lo1ol/DarkroomTimer/DarkroomTimer/src/SettingsSetter.cpp

#include "SettingsSetter.h"

#include "Hardware.h"
#include "Utils.h"

SettingsSetter::SettingsSetter() : m_lagTime(gSettings.lagTime) {
    repaint();
}

SettingsSetter::~SettingsSetter() {
    gBeeper.stop();
    gSettings.lagTime = m_lagTime;
    gSettings.updateEEPROM();
}

void SettingsSetter::processSetLagTime() {
    gSettings.lagTime = 0_s;
    if (gEncoder.getTime(m_lagTime, true)) {
        if (m_lagTime > kMaxLagTime)
            m_lagTime = kMaxLagTime;
        repaint();
    }

    m_timer.tick();
    if (m_timer.state() != Timer::STOPPED || m_timer.justFinished()) {
        repaint();
        return;
    }

    if (gStartBtn.click())
        m_timer.start(m_lagTime);
}

void SettingsSetter::processSetBeepVolume() const {
    if (!gEncoder.getInt(gSettings.beepVolume, kMinBeepVolume, kMaxBeepVolume))
        return;

    gBeeper.start();
    repaint();
}

void SettingsSetter::processSetAutoFinishView() const {
    if (gEncoder.getInt(gSettings.autoFinishViewMinutes, 0, kMaxAutoFinishViewMinutes))
        repaint();
}

void SettingsSetter::processSetBacklight() const {
    if (!gEncoder.getInt(gSettings.backlight, kMinBacklight, kMaxBacklight))
        return;
    setDisplayBacklight(gSettings.backlight);
    repaint();
}

void SettingsSetter::processStartWith() const {
    uint8_t choice = static_cast<uint8_t>(gSettings.startWith);
    if (!gEncoder.getInt(choice, 0, static_cast<uint8_t>(StartWith::last_) - 1))
        return;

    gSettings.startWith = static_cast<StartWith>(choice);
    repaint();
}

void SettingsSetter::processSetMelody() const {
    uint8_t choice = gSettings.melody;

    if (!gEncoder.getInt(choice, 0, Melody::last_ - 1))
        return;

    gSettings.melody = static_cast<Melody::Name>(choice);
    gBeeper.setMelody(gSettings.melody);
    gBeeper.alarm();
    repaint();
}

void SettingsSetter::processIdleTime() const {
    if (!gEncoder.getInt(gSettings.idleAfterMinutes, 0, kMaxIdleAfterMinutes))
        return;

    repaint();
}

void SettingsSetter::processIdleAnimation() {
    if (m_playingIdleAnim) {
        if (!gIdleShower.tick())
            return;

        gIdleShower.stopAnim();
        m_playingIdleAnim = false;
        gDisplay.setupCharset(Charset::Main);
        repaint();
    }

    if (gStartBtn.click()) {
        gIdleShower.startAnim(gSettings.idleAnimation);
        m_playingIdleAnim = true;
    }

    uint8_t choice = gSettings.idleAnimation;
    if (!gEncoder.getInt(choice, 0, DisplayAnimation::last_ - 1))
        return;

    gSettings.idleAnimation = static_cast<DisplayAnimation::Id>(choice);
    repaint();
}

void SettingsSetter::process() {
    if (couldBeClosed()) {
        int8_t shift = 0;
        if (gModeBtn.click())
            shift = 1;
        else if (gModeBtn.pressing()) {
            if ((shift = gEncoder.getDir()))
                gModeBtn.skipEvents();
        }

        if (shift) {
            gEncoder.clear();
            m_step = ADD_TO_ENUM(Step, m_step, shift);

            repaint();
            gBeeper.stop();
            gSettings.lagTime = m_lagTime;
            gSettings.updateEEPROM();
        }
    }

    switch (m_step) {
    case Step::setLagTime:
        processSetLagTime();
        break;
    case Step::setBacklight:
        processSetBacklight();
        break;
    case Step::setBeepVolume:
        processSetBeepVolume();
        break;
    case Step::setAutoFinishView:
        processSetAutoFinishView();
        break;
    case Step::setStartWith:
        processStartWith();
        break;
    case Step::setMelody:
        processSetMelody();
        break;
    case Step::setIdleTime:
        processIdleTime();
        break;
    case Step::setIdleAnimation:
        processIdleAnimation();
        break;
    case Step::checkVersion:
        break;
    case Step::last_:
        assert(false);
        break;
    }
}

void SettingsSetter::repaint() const {
    gDisplay.reset();

    gDisplay[0] << F(kWrenchSymTop " ");
    gDisplay[1] << F(kWrenchSymBottom " ");

    switch (m_step) {
    case Step::setLagTime:
        gDisplay[0] << F("Lag time");
        gDisplay[1] << ((m_timer.state() != Timer::STOPPED) ? Time::fromMillis(m_timer.left()) : m_lagTime);
        return;
    case Step::setBacklight:
        gDisplay[0] << F("Backlight");
        gDisplay[1] << gSettings.backlight;
        return;
    case Step::setBeepVolume:
        gDisplay[0] << F("Beep volume");
        gDisplay[1] << gSettings.beepVolume;
        return;
    case Step::setAutoFinishView:
        gDisplay[0] << F("Auto stop view");

        if (gSettings.autoFinishViewMinutes == 0)
            gDisplay[1] << F("No");
        else
            gDisplay[1] << gSettings.autoFinishViewMinutes << F(" minute")
                        << (gSettings.autoFinishViewMinutes == 1 ? "" : "s");
        return;
    case Step::setStartWith:
        gDisplay[0] << F("Start with");
        switch (gSettings.startWith) {
        case StartWith::Modes:
            gDisplay[1] << F("Modes");
            return;
        case StartWith::Settings:
            gDisplay[1] << F("Settings");
            return;
        case StartWith::last_:
            assert(false);
            return;
        }
        return;
    case Step::setMelody:
        gDisplay[0] << F("Notify melody");
        gDisplay[1] << Melody::getMelodyName(gSettings.melody);
        gDisplay[1] >> F(kBellSym);
        return;
    case Step::setIdleTime:
        gDisplay[0] << F("Idle time");
        if (gSettings.idleAfterMinutes == 0)
            gDisplay[1] << F("No");
        else
            gDisplay[1] << gSettings.idleAfterMinutes << F(" minute") << (gSettings.idleAfterMinutes == 1 ? "" : "s");
        return;
    case Step::setIdleAnimation:
        gDisplay[0] << F("Idle animation");
        gDisplay[1] << DisplayAnimation::getAnimationName(gSettings.idleAnimation);
        return;
    case Step::checkVersion:
        gDisplay[0] << F("Version");
        gDisplay[1] << F(TIMER_FIRMWARE_VERSION);
        return;
    case Step::last_:
        assert(false);
        return;
    }
}

bool SettingsSetter::couldBeClosed() const {
    return m_timer.state() == Timer::STOPPED && !m_playingIdleAnim;
}
