lo1ol/DarkroomTimer/DarkroomTimer/src/DisplayAnimation.h

#pragma once

#include <Arduino.h>
#include <stdint.h>

#if __has_include("new.h")
    #include <new.h>
#else
    #include <cstddef>
    #include <new>
#endif

struct ImgDesc {
    const uint8_t* img;
    uint8_t height;
    uint8_t width;
    uint8_t bytesInRow;
};

struct RenderedImgDesc {
    char row0Str[7];
    char row1Str[7];
    uint8_t customSymsCnt = 0;
    uint8_t customSyms[8][8];
};

class DisplayAnimation {
public:
    DisplayAnimation();

    // return time to next update
    virtual uint16_t tick() = 0;

    // random has to be first
    enum Id { random, dvd, dickKicker, sleepyTimer, spaceship, last_ };

    virtual ~DisplayAnimation() = default;

    // This class shouldn't be created in heap
    // Use placement new instead
    // It allows us to reduce firmware memory about 3%
    static void* operator new(size_t) = delete;
    static void* operator new(size_t size, void* location) { return ::operator new(size, location); }

    static void operator delete(void*) {}

    [[nodiscard]] static DisplayAnimation* createAnimation(Id);
    [[nodiscard]] static const __FlashStringHelper* getAnimationName(Id);

protected:
    static RenderedImgDesc renderImg(const ImgDesc& img, uint8_t xOffset, uint8_t yOffset);
    static void printRenderedImg(const RenderedImgDesc& desc, const int8_t col);
};

class BounceAnimation : public DisplayAnimation {
public:
    BounceAnimation(const ImgDesc* imgDesc, uint8_t xShift, uint8_t yShift);

    uint16_t tick() override;

private:
    int8_t m_xPos = 0;
    int8_t m_yPos = 0;

    int8_t m_xShift = 2;
    int8_t m_yShift = 1;
    const ImgDesc* m_imgDesc;
    const uint8_t kBaseXShift;
    const uint8_t kBaseYShift;
};

class DvdAnimation : public BounceAnimation {
public:
    DvdAnimation();
};

class RussianDickKicker : public DisplayAnimation {
public:
    uint16_t tick() override;

private:
    uint8_t m_currentFrame = 0;
    int8_t m_xPos = -4;
};

class SleepyTimer : public DisplayAnimation {
public:
    enum Phase : uint8_t { WakedUp, GoingToSleep, Sleep, WakingUp, last_ };

    uint16_t tick() override;

private:
    void setPhaseChars();
    void nextPhase();

    Phase m_phase = Phase::WakedUp;
    uint8_t m_inPhaseTime = 0;
};

class SpaceShip : public DisplayAnimation {
public:
    SpaceShip();

    uint16_t tick() override;

private:
    enum SpaceObject : uint8_t {
        Nothing,
        Star1,
        Star2,
        TwoStars,
        MiddleStar,
        BigStar,
        HugeStar,
        Planet,
        Galactic,
        Enemy,
        Satellite,
    };

    void shiftSpace();
    void shiftSpaceShip();
    char getSpaceObjectSym(SpaceObject);

    int8_t m_spaceshipYPos = 3;
    int8_t m_spaceShipDir = 0;

    uint16_t m_phase = 0;

    // each 4 bit of this object describes SpaceObject
    uint64_t m_r0spaceObjects;
    uint64_t m_r1spaceObjects;
    uint8_t m_lastBigObjectDistance = 0;
};
