lo1ol/DarkroomTimer/DarkroomTimer/src/Display.cpp

#include "Display.h"

#include "Lcd.h"

Display::Display(Lcd* lcd) : m_lcd(lcd) {
    int i = 0;
    for (auto& line : m_lines)
        line = DisplayLine(i++, m_lcd);
}

void Display::tick() {
    for (auto&& line : m_lines)
        line.tick();
}

void Display::reset() {
    for (auto&& line : m_lines)
        line.reset();
}

void Display::resetBlink(bool showBlinked) {
    for (auto&& line : m_lines)
        line.resetBlink(showBlinked);
}

void Display::setupCharset(Charset charset) {
#define ADD_CUSTOM_CHAR(symStr, symMatrix) m_lcd->addPROGMEMCustomChar(static_cast<uint8_t>(symStr[0]), symMatrix)
    switch (charset) {
    case Charset::Main:
        ADD_CUSTOM_CHAR(kWrenchSymTop, kWrenchSymTopMatrix);
        ADD_CUSTOM_CHAR(kWrenchSymBottom, kWrenchSymBottomMatrix);
        ADD_CUSTOM_CHAR(kSheetSym, kSheetSymMatrix);
        ADD_CUSTOM_CHAR(kPlaySym, kPlaySymMatrix);
        ADD_CUSTOM_CHAR(kPauseSym, kPauseSymMatrix);
        ADD_CUSTOM_CHAR(kBellSym, kBellSymMatrix);
        break;
    case Charset::ModePreview:
        ADD_CUSTOM_CHAR(kFolderBegin1Sym, kFolderBegin1SymMatrix);
        ADD_CUSTOM_CHAR(kFolderEnd1Sym, kFolderEnd1SymMatrix);
        ADD_CUSTOM_CHAR(kFolderBegin2Sym, kFolderBegin2SymMatrix);
        ADD_CUSTOM_CHAR(kFolderBegin3Sym, kFolderBegin3SymMatrix);
        ADD_CUSTOM_CHAR(kFolderEnd3Sym, kFolderEnd3SymMatrix);
        ADD_CUSTOM_CHAR(kFolderBegin4Sym, kFolderBegin4SymMatrix);
        ADD_CUSTOM_CHAR(kFolderEnd4Sym, kFolderEnd4SymMatrix);
        ADD_CUSTOM_CHAR(kSubFolderPointerSym, kSubFolderPointerSymMatrix);
        break;
    case Charset::View:
        ADD_CUSTOM_CHAR(kLampSym, kLampSymMatrix);
        ADD_CUSTOM_CHAR(kLampLight1Sym, kLampLight1SymMatrix);
        ADD_CUSTOM_CHAR(kLampLight2Sym, kLampLight2SymMatrix);
        ADD_CUSTOM_CHAR(kLampLight3Sym, kLampLight3SymMatrix);
        ADD_CUSTOM_CHAR(kLampLight4Sym, kLampLight4SymMatrix);
        ADD_CUSTOM_CHAR(kLampLight5Sym, kLampLight5SymMatrix);
        ADD_CUSTOM_CHAR(kLampLight6Sym, kLampLight6SymMatrix);
        break;
    }
#undef ADD_CUSTOM_CHAR
}

#ifndef PIO_UNIT_TESTING

void Display::playLogo() {
    reset();
    tick();

    m_lines[0].printWithAnimation(F("    RED RAY"), 1400);

    while (m_lines[0].animationIsRunning())
        m_lines[0].tick();

    delay(600);

    m_lines[1] << F("  Let's print   ");
    m_lines[1].tick();
    delay(1200);

    reset();
}
#endif
