lo1ol/DarkroomTimer/DarkroomTimer/src/LcdImpl/Direct.cpp

#include "../Config.h"

#if LCD_VERSION == LCD_VERSION_DIRECT && !defined(PIO_UNIT_TESTING)

    #include "../CustomChars.h"
    #include "../Hardware.h"
    #include "Direct.h"

namespace {

void lcdPulseEnable() {
    gDigitalWrite(LCD_EN_PIN, true);
    delayMicroseconds(1);
    gDigitalWrite(LCD_EN_PIN, false);
    delayMicroseconds(100);
}

void lcdWrite4bits(uint8_t value) {
    gDigitalWrite(LCD_D4_PIN, (value >> 0) & 0x01);
    gDigitalWrite(LCD_D5_PIN, (value >> 1) & 0x01);
    gDigitalWrite(LCD_D6_PIN, (value >> 2) & 0x01);
    gDigitalWrite(LCD_D7_PIN, (value >> 3) & 0x01);
    lcdPulseEnable();
}

void lcdSend(uint8_t value, bool rs) {
    gDigitalWrite(LCD_RS_PIN, rs);
    lcdWrite4bits(value >> 4);
    lcdWrite4bits(value);
}

inline void lcdCmd(uint8_t cmd) {
    lcdSend(cmd, false);
}

inline void lcdData(uint8_t data) {
    lcdSend(data, true);
}

} // namespace

void Lcd::init() {
    gPinMode(LCD_RS_PIN, OUTPUT);
    gPinMode(LCD_EN_PIN, OUTPUT);
    gPinMode(LCD_D4_PIN, OUTPUT);
    gPinMode(LCD_D5_PIN, OUTPUT);
    gPinMode(LCD_D6_PIN, OUTPUT);
    gPinMode(LCD_D7_PIN, OUTPUT);

    delay(50);
    lcdWrite4bits(0x03);
    delay(5);
    lcdWrite4bits(0x03);
    delayMicroseconds(150);
    lcdWrite4bits(0x03);
    lcdWrite4bits(0x02);

    lcdCmd(0x28);
    lcdCmd(0x0C);
    lcdCmd(0x06);

    clear();
}

void Lcd::setCursor(uint8_t c, uint8_t r) {
    static uint8_t rowOffsets[] = { 0x00, 0x40 };
    lcdCmd(0x80 | (c + rowOffsets[r]));
}

void Lcd::print(const char* str) {
    while (uint8_t ch = *str++) {
        if (ch >= 0x80)
            ch -= 0x80;
        lcdData(ch);
    }
}

void Lcd::print(char ch_) {
    uint8_t ch = ch_;
    if (ch >= 0x80)
        ch -= 0x80;
    lcdData(ch);
}

void Lcd::clear() {
    lcdCmd(0x01);
    delay(2);
}

void Lcd::addPROGMEMCustomChar(uint8_t location, const uint8_t (&matrix)[8]) {
    lcdCmd(0x40 | (location & 0x0F) << 3);
    for (uint8_t i = 0; i != sizeof(matrix); ++i)
        lcdData(pgm_read_byte(matrix + i));
}

void Lcd::addRAMCustomChar(uint8_t location, const uint8_t (&matrix)[8]) {
    lcdCmd(0x40 | (location & 0x0F) << 3);
    for (uint8_t i = 0; i != sizeof(matrix); ++i)
        lcdData(matrix[i]);
}

#endif
