lo1ol/DarkroomTimer/DarkroomTimer/src/SettingsSetter.h

#include "ModeProcessor.h"

#include "Timer.h"

#include <stdint.h>

class SettingsSetter final {
public:
    enum class Step {
        setLagTime,
        setBacklight,
        setBeepVolume,
        setAutoFinishView,
        setStartWith,
        setMelody,
        setIdleTime,
        setIdleAnimation,
        checkVersion,
        last_
    };

    SettingsSetter();
    ~SettingsSetter();

    void process();
    void repaint() const;

    [[nodiscard]] bool couldBeClosed() const;

private:
    void processSetLagTime();
    void processSetBacklight() const;
    void processSetBeepVolume() const;
    void processSetAutoFinishView() const;
    void processStartWith() const;
    void processSetMelody() const;
    void processIdleTime() const;
    void processIdleAnimation();

    Step m_step = Step::setLagTime;
    Time m_lagTime;
    Timer m_timer{};
    bool m_playingIdleAnim = false;
};
