lo1ol/DarkroomTimer/DarkroomTimer/src/Display.h

#pragma once

#include "Config.h"
#include "CustomChars.h"
#include "DisplayLine.h"
#include "TimeTable.h"

class Lcd;

class Display {
public:
    explicit Display(Lcd* lcd);
    [[nodiscard]] DisplayLine& operator[](uint8_t n) { return m_lines[n]; }
    [[nodiscard]] DisplayLine* getLines() { return m_lines; }

#ifndef PIO_UNIT_TESTING
    void playLogo();
#endif

    void tick();
    void reset();
    void resetBlink(bool showBlinked);
    void setupCharset(Charset charset);

private:
    Lcd* m_lcd;
    DisplayLine m_lines[DISPLAY_ROWS];
};
