lo1ol/DarkroomTimer/test/parts/test_encoder/main.cpp

#include <Arduino.h>
#include <unity.h>

#include <Hardware.h>

void setUp() {
    gEncoder.clear();
}

void tearDown() {}

#define TEST_ASSERT_EQUAL_TIME(t1, t2) TEST_ASSERT_EQUAL((t1).toMillis(), (t2).toMillis());

void checkEncoderDir() {
    gEncoder.emulTurns(2);
    TEST_ASSERT_EQUAL(0, gEncoder.getDir());

    gEncoder.tick();
    TEST_ASSERT_EQUAL(1, gEncoder.getDir());

    gEncoder.emulTurns(-3);
    gEncoder.tick();
    TEST_ASSERT_EQUAL(-1, gEncoder.getDir());

    gEncoder.emulFastTurns(-3);
    gEncoder.tick();
    TEST_ASSERT_EQUAL(-1, gEncoder.getDir());

    gEncoder.emulTurns(3);
    gEncoder.emulFastTurns(-3);
    gEncoder.tick();
    TEST_ASSERT_EQUAL(0, gEncoder.getDir());

    gEncoder.emulTurns(4);
    gEncoder.emulFastTurns(-3);
    gEncoder.tick();
    TEST_ASSERT_EQUAL(1, gEncoder.getDir());

    gEncoder.emulTurns(-7);
    gEncoder.emulFastTurns(3);
    gEncoder.emulFastFastTurns(2);
    gEncoder.tick();
    TEST_ASSERT_EQUAL(-1, gEncoder.getDir());
}

void checkEncoderInt() {
    uint8_t val = 3;
    TEST_ASSERT(!gEncoder.getInt(val, 0, 6));
    TEST_ASSERT_EQUAL(3, val);

    gEncoder.emulTurns(2);
    TEST_ASSERT(!gEncoder.getInt(val, 0, 6));
    TEST_ASSERT_EQUAL(3, val);

    gEncoder.tick();
    TEST_ASSERT(gEncoder.getInt(val, 0, 6));
    TEST_ASSERT_EQUAL(5, val);

    gEncoder.tick();
    TEST_ASSERT(!gEncoder.getInt(val, 0, 6));
    TEST_ASSERT_EQUAL(5, val);

    gEncoder.emulTurns(-2);
    gEncoder.tick();
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
    gEncoder.tick();
    TEST_ASSERT(gEncoder.getRelTime(t));
    TEST_ASSERT_EQUAL(3, t.getId());

    t = RelTime{ kMaxRelTime.getId() - 1 };
    gEncoder.emulTurns(1);
    gEncoder.tick();
    TEST_ASSERT(gEncoder.getRelTime(t));
    TEST_ASSERT_EQUAL(kMaxRelTime.getId(), t.getId());

    gEncoder.emulTurns(1);
    gEncoder.tick();
    TEST_ASSERT(!gEncoder.getRelTime(t));
    TEST_ASSERT_EQUAL(kMaxRelTime.getId(), t.getId());

    t = RelTime{ kMaxRelTime.getId() - 1 };
    gEncoder.emulFastTurns(1);
    gEncoder.tick();
    TEST_ASSERT(gEncoder.getRelTime(t));
    TEST_ASSERT_EQUAL(kMaxRelTime.getId(), t.getId());

    gEncoder.emulFastTurns(1);
    gEncoder.tick();
    TEST_ASSERT(!gEncoder.getRelTime(t));
    TEST_ASSERT_EQUAL(kMaxRelTime.getId(), t.getId());

    t = RelTime{ 1 };
    gEncoder.emulTurns(-1);
    gEncoder.tick();
    TEST_ASSERT(gEncoder.getRelTime(t));
    TEST_ASSERT_EQUAL(0, t.getId());

    gEncoder.emulTurns(-1);
    gEncoder.tick();
    TEST_ASSERT(!gEncoder.getRelTime(t));
    TEST_ASSERT_EQUAL(0, t.getId());

    t = RelTime{ 1 };
    gEncoder.emulFastTurns(-1);
    gEncoder.tick();
    TEST_ASSERT(gEncoder.getRelTime(t));
    TEST_ASSERT_EQUAL(0, t.getId());

    gEncoder.emulFastTurns(-1);
    gEncoder.tick();
    TEST_ASSERT(!gEncoder.getRelTime(t));
    TEST_ASSERT_EQUAL(0, t.getId());

    gEncoder.emulRetRelTime(RelTime{ 7 });
    gEncoder.tick();
    TEST_ASSERT(gEncoder.getRelTime(t));
    TEST_ASSERT_EQUAL(7, t.getId());

    gEncoder.emulRetRelTime(RelTime{ 7 });
    gEncoder.tick();
    TEST_ASSERT(gEncoder.getRelTime(t));
    TEST_ASSERT_EQUAL(7, t.getId());

    t = RelTime{ 2 };
    gEncoder.emulRetRelTime(RelTime{ 7 });
    gEncoder.tick();
    gEncoder.tick();
    TEST_ASSERT(!gEncoder.getRelTime(t));
    TEST_ASSERT_EQUAL(2, t.getId());

    t = RelTime{ kMaxRelTime.getId() + 1 };
    gEncoder.tick();
    TEST_ASSERT(gEncoder.getRelTime(t));
    TEST_ASSERT_EQUAL(kMaxRelTime.getId(), t.getId());
}

int main() {
    UNITY_BEGIN();
    RUN_TEST(checkEncoderDir);
    RUN_TEST(checkEncoderInt);
    RUN_TEST(checkEncoderTime);
    RUN_TEST(checkEncoderRelTime);
    UNITY_END();
}
