lo1ol/DarkroomTimer/test/parts/test_timer/main.cpp

#include <Arduino.h>
#include <unity.h>

#include <Hardware.h>

void setUp() {
    gCurrentTime = 0;
    gRelayVal = 0;
    gSettings.lagTime = 0_ts;
    gTimer = Timer{};
    gBeeper.stop();
}

void tearDown() {}

#define TEST_ASSERT_EQUAL_TIME(t1, t2) TEST_ASSERT_EQUAL((t1).toMillis(), (t2).toMillis());

void checkTimerStart() {
    gTimer.start(1_s);
    TEST_ASSERT_EQUAL(false, gTimer.justFinished());
    TEST_ASSERT_EQUAL(Timer::State::RUNNING, gTimer.state());
    gTimer.tick();
    TEST_ASSERT_EQUAL(Timer::State::RUNNING, gTimer.state());

    gCurrentTime += 999;
    gTimer.tick();
    TEST_ASSERT_EQUAL(Timer::State::RUNNING, gTimer.state());
    gCurrentTime += 1;
    gTimer.tick();
    TEST_ASSERT_EQUAL(Timer::State::STOPPED, gTimer.state());
    TEST_ASSERT_EQUAL(true, gTimer.justFinished());

    gTimer.start(0_s);
    TEST_ASSERT_EQUAL(Timer::State::STOPPED, gTimer.state());
    TEST_ASSERT_EQUAL(true, gTimer.justFinished());
    gTimer.tick();
    TEST_ASSERT_EQUAL(Timer::State::STOPPED, gTimer.state());
    TEST_ASSERT_EQUAL(false, gTimer.justFinished());
}

void checkTimerPauseResume() {
    gTimer.start(2_s);
    gTimer.tick();
    TEST_ASSERT_EQUAL(Timer::State::RUNNING, gTimer.state());

    gCurrentTime += 950;
    gTimer.tick();
    TEST_ASSERT_EQUAL(1050, gTimer.left());
    TEST_ASSERT_EQUAL_TIME(9_ts, gTimer.afterLastResume());
    gTimer.pause();
    TEST_ASSERT_EQUAL(Timer::State::PAUSED, gTimer.state());
    TEST_ASSERT_EQUAL(1050, gTimer.left());
    TEST_ASSERT_EQUAL_TIME(9_ts, gTimer.afterLastResume());
    gTimer.tick();
    TEST_ASSERT_EQUAL(Timer::State::PAUSED, gTimer.state());
    TEST_ASSERT_EQUAL(1050, gTimer.left());
    TEST_ASSERT_EQUAL_TIME(9_ts, gTimer.afterLastResume());

    gCurrentTime += 3000;
    gTimer.tick();
    TEST_ASSERT_EQUAL(Timer::State::PAUSED, gTimer.state());
    TEST_ASSERT_EQUAL(1050, gTimer.left());
    TEST_ASSERT_EQUAL_TIME(9_ts, gTimer.afterLastResume());

    gTimer.resume();
    gTimer.tick();
    TEST_ASSERT_EQUAL(Timer::State::RUNNING, gTimer.state());
    TEST_ASSERT_EQUAL(1050, gTimer.left());
    // timer count time after resume only after it became greater then 0
    TEST_ASSERT_EQUAL_TIME(9_ts, gTimer.afterLastResume());

    gCurrentTime += 799;
    gTimer.tick();
    TEST_ASSERT_EQUAL(Timer::State::RUNNING, gTimer.state());
    TEST_ASSERT_EQUAL(251, gTimer.left());
    TEST_ASSERT_EQUAL_TIME(8_ts, gTimer.afterLastResume());

    gCurrentTime += 251;
    gTimer.tick();
    gTimer.pause();
    TEST_ASSERT_EQUAL(Timer::State::STOPPED, gTimer.state());
    TEST_ASSERT_EQUAL(true, gTimer.justFinished());
    // we are not paused
    TEST_ASSERT_EQUAL_TIME(10_ts, gTimer.afterLastResume());
}

void checkTimerStop() {
    gTimer.start(2_s);
    TEST_ASSERT_EQUAL(Timer::State::RUNNING, gTimer.state());
    gTimer.tick();
    gTimer.stop();
    TEST_ASSERT_EQUAL(Timer::State::STOPPED, gTimer.state());
    TEST_ASSERT_EQUAL(false, gTimer.justFinished());
    gTimer.tick();
    TEST_ASSERT_EQUAL(Timer::State::STOPPED, gTimer.state());
    TEST_ASSERT_EQUAL(false, gTimer.justFinished());
}

void checkTimerTotal() {
    gTimer.start(2_s);
    gTimer.tick();
    gCurrentTime += 2500;
    gTimer.tick();
    TEST_ASSERT_EQUAL_TIME(20_ts, gTimer.total());
    TEST_ASSERT_EQUAL_TIME(20_ts, gTimer.afterLastResume());
    gTimer.reset();

    gTimer.start(2_s);
    gTimer.tick();
    gCurrentTime += 1000;
    gTimer.tick();
    TEST_ASSERT_EQUAL_TIME(10_ts, gTimer.total());
    gTimer.reset();

    gTimer.start(2_s);
    gTimer.tick();
    gCurrentTime += 3000;
    gTimer.tick();

    gTimer.start(3_s);
    gTimer.tick();
    gCurrentTime += 2000;
    gTimer.tick();
    TEST_ASSERT_EQUAL_TIME(40_ts, gTimer.total());
    gTimer.resetTotal();
    // timer still is on and 2 seconds passed
    TEST_ASSERT_EQUAL_TIME(20_ts, gTimer.total());

    gCurrentTime += 1000;
    gTimer.tick();
    TEST_ASSERT_EQUAL_TIME(30_ts, gTimer.total());
    gTimer.resetTotal();
    TEST_ASSERT_EQUAL_TIME(0_ts, gTimer.total());
}

void checkTimerLag() {
    gSettings.lagTime = 1_s;
    gTimer.start(2_s);
    gTimer.tick();
    TEST_ASSERT_EQUAL(true, gTimer.lag());
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

    gCurrentTime += 950;
    gTimer.tick();
    gBeeper.tick();
    TEST_ASSERT_EQUAL(Beeper::State::off, gBeeper.state());

    gCurrentTime += 50;
    gTimer.tick();
    gBeeper.tick();
    TEST_ASSERT_EQUAL(Beeper::State::on, gBeeper.state());

    gCurrentTime += 950;
    gTimer.tick();
    gBeeper.tick();
    TEST_ASSERT_EQUAL(Beeper::State::on, gBeeper.state());

    gCurrentTime += 50;
    gTimer.tick();
    gBeeper.tick();
    TEST_ASSERT_EQUAL(Beeper::State::off, gBeeper.state());
}

int main() {
    UNITY_BEGIN();
    RUN_TEST(checkTimerStart);
    RUN_TEST(checkTimerPauseResume);
    RUN_TEST(checkTimerStop);
    RUN_TEST(checkTimerTotal);
    RUN_TEST(checkTimerLag);
    RUN_TEST(checkTimerRelay);
    RUN_TEST(checkTimerBeeper);
    UNITY_END();
}
