lo1ol/DarkroomTimer/DarkroomTimer/src/Utils.h

#pragma once

#include <stdint.h>

#define ADD_TO_ENUM(enumName, current, num) \
    (enumName)(((uint8_t)(current) + (uint8_t)enumName::last_ + num) % (uint8_t)enumName::last_)

#define ARRAY_SIZE(a) sizeof(a) / sizeof(a[0])

void alignStr(char* buf, uint8_t align);

// 3 times faster then pow(2, exp)
// has acuracy 0.01% compare to it
float fast2pow(float exp);
