lo1ol/DarkroomTimer/test/scenarios/test_expert_test_modes/UserConfig.h

// clang-format off
#define TIMER_MODES       \
    expertFStopTest,      \
    expertLinearTest,     \
    print,                \
    mask,                 \
    splitGradeMask,       \
    last_,                \
    fStopTest,            \
    linearTest,           \
    splitGradeFStopTest,  \
    splitGradeLinearTest, \
    localizedFStopTest,   \
    localizedLinearTest,  \
    relMask,              \
    splitGradeRelMask,
// clang-format on
