lo1ol/DarkroomTimer/(commit log)

2024-06-08 Add beeper to timer
2024-06-08 Add relay
2024-06-08 Use EncButton lib instead of Button and RotaryEncoder
2024-06-08 Fix encoder bad response
    [Tools.cpp, Tools.h]
2024-06-08 Improve info in Print mode
2024-06-08 Add ability to reset modes by holding extra btn
    [FStopTestMode.cpp, FStopTestMode.h, LinearTestMode.cpp, LinearTestMode.h, MaskMode.cpp, MaskMode.h, ModeProcessor.h, PrintMode.cpp]
2024-07-03 Add ability to run timer by Hold in Print mode
2024-07-03 Add beep signal while press start btn
    After using SSR instad of simple relay the sound of start disappeared.
    So, lets compensate it by adding beep sound during click
2024-07-03 Add body model and electric circuit
2024-07-03 Add ability to control backlight of LED
2024-07-03 Fix buffer overflow, when concat strings
    [Tools.cpp, Tools.h]
2024-07-03 Move to PlatfromIO from Arduino IDE
    Just compiling and uploading of code from Arduino IDE is still
    possiable for dummies
2024-07-03 Rename Time Relay to Timer
2024-07-03 Prevent acedent go to settings
    [main.cpp]
2024-07-03 Fix set of lag time during printing
    [SettingsSetter.cpp, SettingsSetter.h, Timer.h]
2024-07-03 Fix check settings was corrupted
    [Settings.cpp]
2024-07-03 Show time after last resume in print mode
2024-07-03 Back printing of tenth
    It's show user that something is going on
2024-07-03 Fix clothing of SettingSetter if timer run
    [SettingsSetter.cpp, SettingsSetter.h, main.cpp]
2024-07-03 Let's print log in modes
2024-07-03 Add log to print mode
2024-07-03 Swap some functionality of mode btn and extra btn
    It's more logical. Now everything, what connected with mode is handled
    by mode btn. And extra btn handle some extra functianality
    [FStopTestMode.cpp, LinearTestMode.cpp, MaskMode.cpp, PrintMode.cpp, main.cpp]
2024-07-03 Add switch mode virtual function to ModeProcessor
2024-07-03 Highlight first non-printed value in log
2024-07-04 Allow to print in log for some modes
2024-07-04 Auto exit printing log if it was overflowed
2024-07-06 Add ability to switch run view for some modes
2024-07-06 Allow fast trevel in settings using encoder and pressing mode btn
2024-07-06 Simplify mask mode switch
2024-07-06 Fix guessing of masks in mask mode
    [MaskMode.cpp, MaskMode.h, Time.h]
2024-07-06 Don't run timer if time is 0
2024-07-07 Fix time alignment, while set time
    [Tools.cpp]
2024-07-07 Add preview of current mode while switch them
2024-07-07 Reset log view while switch modes
    [main.cpp]
2024-07-10 Add Beeper class to easy control buzzer
    [Beeper.cpp, Beeper.h, SettingsSetter.cpp, SettingsSetter.h, Timer.cpp, Timer.h, Tools.cpp, Tools.h]
2024-07-10 Play melody after printing base in split grade
2024-07-10 Add ability to set notification in mask mode after printing some masks
2024-07-12 Disable click handling if we fast tap mode btn and turn encoder
2024-07-12 Pause printing by press and start only by clicking start btn in Print mode
2024-07-13 Fix printing more then mask number in mask mode
    [MaskMode.cpp]
2024-07-14 Fix overflow in Time in some cases
    [FStopTestMode.cpp, FStopTestMode.h, LinearTestMode.cpp, LinearTestMode.h, MaskMode.cpp, ModeProcessor.h, PrintMode.cpp, Time.h]
2024-07-14 Fix reset of mask notifications while switch mode
    [MaskMode.cpp]
2024-07-14 Fix ability to set base time in simple linear test mode
    [LinearTestMode.cpp]
2024-07-27 Remove bad info about capacitor in circuit
2024-10-31 Move to more efficient method of printing to display
2024-11-02 Move to new mechanism of printing time tables
2024-11-02 Stop reset current mode in preview if it doesn't changed
    [FStopTestMode.h, LinearTestMode.h, MaskMode.h, ModeProcessor.h, PrintMode.h, main.cpp]
2024-11-03 Return log to print mode
2024-11-16 Fix ntf in mask mode
    [MaskMode.cpp]
2024-11-16 Fix wrong mask printing in Split Mask Mode
    [MaskMode.cpp]
2024-11-16 Fix bad memory access in mask modes
    [MaskMode.cpp, RelMaskMode.cpp]
2024-12-28 Move all sources to DarkroomTimer
    Arduino IDE requires that name of ino file will be equal to directory name
    Let's make it
2025-01-14 Fix encoder link and add info about normal transformer to readme
2025-02-03 Add warning about led lamps
2025-02-19 Add info about SSR for led lamps
2025-05-16 Fix View msg after view autostop time
    [main.cpp]
2025-05-18 Add local printing tests
2025-06-04 Add online simulator of device
2025-06-20 Add Power supply circuit
2025-07-01 Remove useless dimming resistor
2025-07-02 Add ability to castomize buzzer volume in Config.h
    Also, change default config values for suggested buzzer from aliexpress
    [Beeper.cpp, Config.h, Settings.cpp, SettingsSetter.cpp]
2025-07-08 Let's move switch of Display in Main Body to Anode
2025-07-21 Add youtube playlist with assembling manual
2025-07-28 Simplify printing of TimeTables
2025-07-31 Add ability to override millis and write functions
2025-07-31 Simplify a little bit timer and refactor print mode
2025-07-31 Add timer tests
2025-08-01 Add check Relay to Timer tests
2025-08-01 Add tests for beeper in timer
2025-08-02 Allow to fast repaint only current in DisplayLine
2025-08-02 Add efficincy test on display print function calling
2025-08-02 Move to other way of mocking millis and *Write functions
2025-08-02 Let's test wrapers over encoder and button
2025-08-02 Add encoder tests
2025-08-04 Fix reset at print mode
2025-08-04 Add tests for print mode
2025-08-05 Add proper handling of over flows to RelTimeTable
2025-08-05 Adjust Fast encoder turn time
2025-08-05 Fix reset in FStopTest mode during printing
    Firstly we call reset in FStopTest mode
    It resets current element inside ScrollableContent
    Timer still was not stopped
    We tried to repaint ScrollableContent and fails because we tried to
    align Timer's left time to too small string of current element
    [main.cpp]
2025-08-06 Fix logic of goint to current line at Scrollable content
    [PrintMode.cpp, ScrollableContent.cpp, ScrollableContent.h]
2025-08-06 Fix memory leaks in tests
    [Beeper.cpp, Beeper.h, main.cpp]
2025-08-07 Stop to call analogWrite of beeper if pin wasn't changed
2025-08-07 Fix not showing of prefix in log view of printing time
    [FStopTestMode.cpp, LinearTestMode.cpp, MaskMode.cpp, PrintMode.cpp, RelMaskMode.cpp, main.cpp]
2025-08-08 Fix memory leak in tests inside Beeper
    [Beeper.cpp]
2025-08-09 Move to custom Encoder implementation
    1. It uses less memory
    2. It's responds faster on users changes
    3. It will be much more easear add more logic to it in future
2025-08-09 Fix bad memory access at RelMaskMode
    [RelMaskMode.cpp]
2025-08-09 Fix printing of bad time after fast treveling in MaskMode
    [DTEncoder.cpp, main.cpp]
2025-08-10 Make getting time using encoder more consistent and faster
2025-08-10 Add second speed on encoder
2025-08-12 Add job to check project build on Arduino IDE
2025-08-24 Allow to start printing at tests modes even if not see current time
2025-08-31 Add I2C implementation for working with display
2025-08-31 Let's use our version of Wire for working with i2c to decrease firmware size
2025-08-31 Add info about I2C LCD to readme
2025-09-02 Speed up I2C communication by reducing number of transactions
2025-09-27 Update defult SSR pin number
    A4 used for I2C output, So, let's use D4 pin instead
2025-10-15 Move platformio specific files to root
    fix User Config in git index
    [Tools.h, main.cpp]
2025-10-15 Fix Artifacts on I2C after reset
    [I2C.cpp]
2025-10-18 Fix info about wires
2025-11-13 Replace pow function to custom fast2pow
    [FStopTestMode.cpp, RelTime.cpp, Utils.cpp, Utils.h]
2025-11-13 Update info about wires at README
2025-11-15 Fix tests after adding custom chars
    [CustomChars.h, Melody.cpp, PrintMode.cpp, Test.h, main.cpp]
2025-11-15 Fix backlight on logo
    [main.cpp]
2025-11-16 Add info how to configure timer to FAQ
2025-11-23 Fix Mode preview not setup icons in some case
    [main.cpp]
2026-03-12 Fix I2C scheme
2026-04-07 Fix enum overflow while set starting menu
    [SettingsSetter.cpp]
2026-04-15 Add Idle animation to timer
2026-04-16 Let's store animation frames at PROGMEM
2026-04-16 Allow to use anims on I2C displays
2026-04-16 Fix tests after adding idle animation
    [DisplayAnimation.cpp, IdleShower.cpp, Test.h, main.cpp]
2026-04-17 Add sleepy timer animation
2026-04-18 Fix idle interruption by encoder
    [main.cpp]
2026-04-18 Ignore any event from encoder if timer was waked up by it
